weblerson/v2v/pcb/fab/render-revA.png

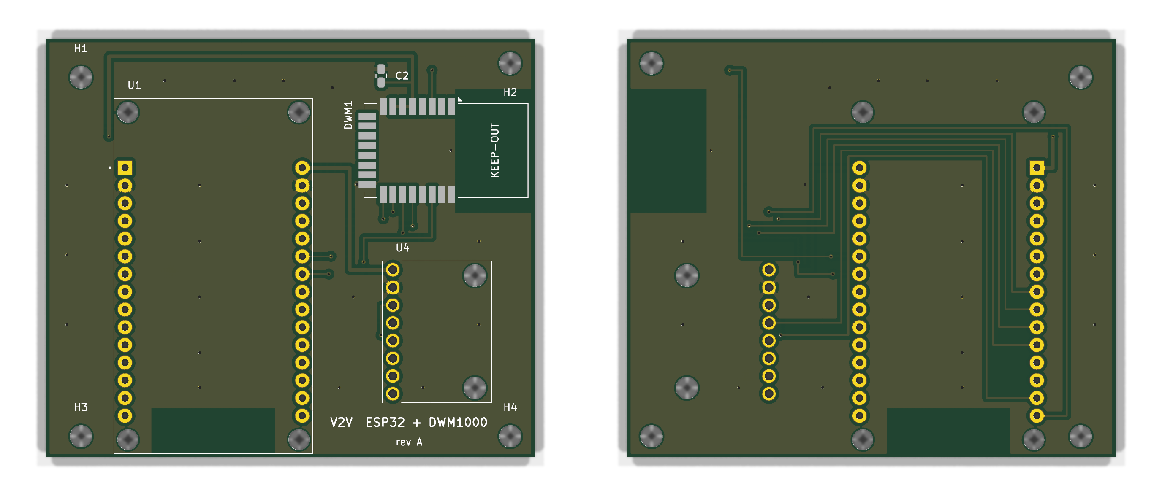
pcb/fab/render-revA.png
