weblerson/v2v/pcb/pcb.kicad_pcb

## KiCad design pcb/pcb.kicad_pcb (2026-09-01)

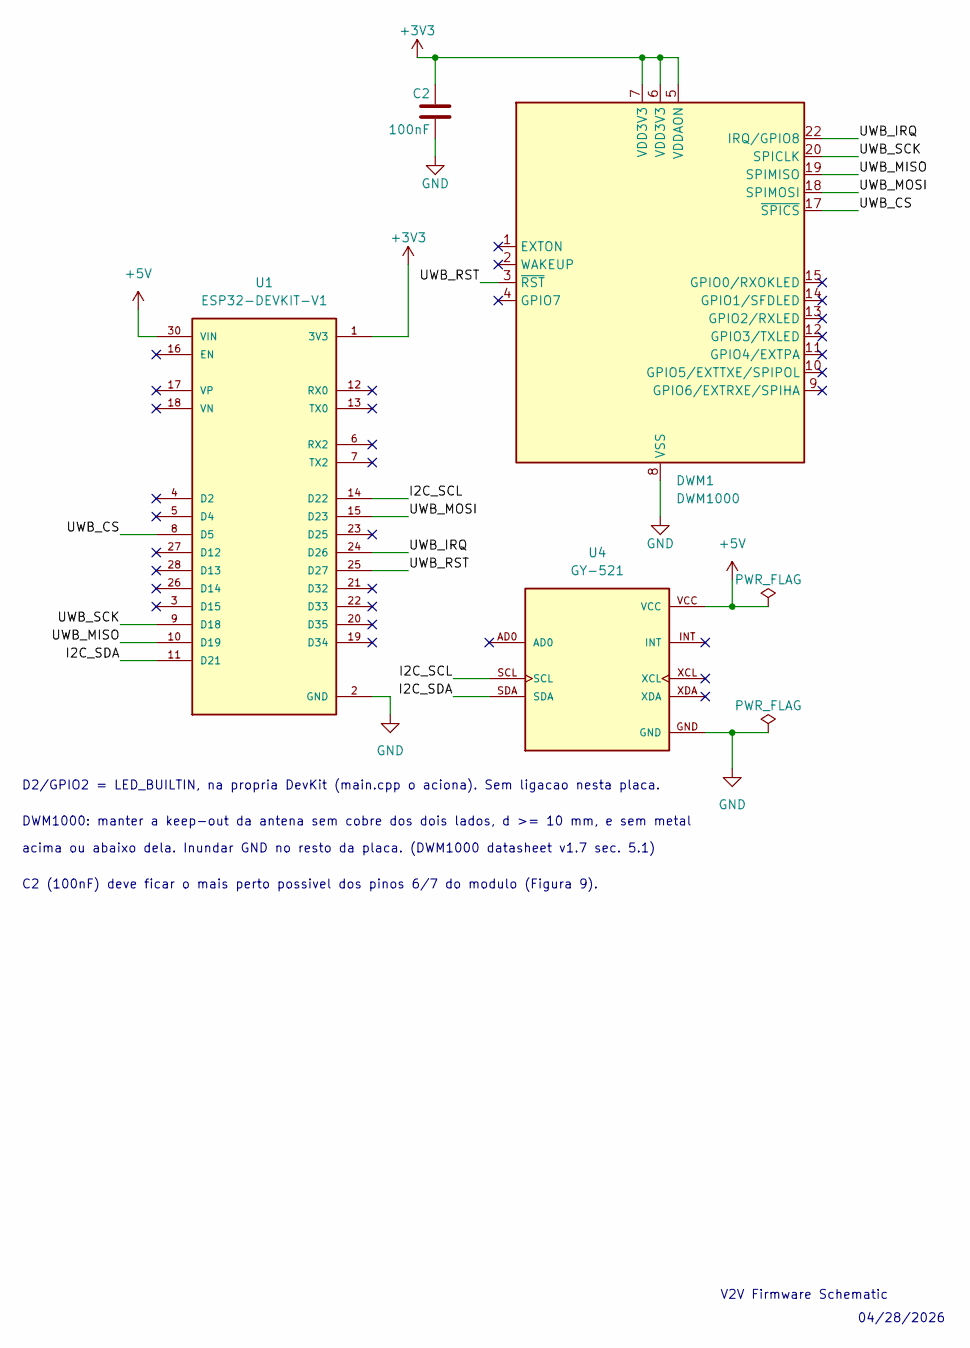
[picture p2: schematic pcb.kicad_sch]

Parts:
C2: 100nF; C_0805_2012Metric
DWM1: DWM1000
U1: ESP32-DEVKIT-V1; MODULE_ESP32_DEVKIT_V1; PARTREV N/A
U4: GY-521; MODULE_GY-521; PARTREV NA

Connections:
+3V3: C2.1, DWM1.5 (VDDAON), DWM1.6 (VDD3V3), DWM1.7 (VDD3V3), U1.1 (3V3)
+5V: U1.30 (VIN), U4.VCC
/I2C_SCL: U1.14 (D22), U4.SCL
/I2C_SDA: U1.11 (D21), U4.SDA
/UWB_CS: DWM1.17 (~SPICS), U1.8 (D5)
/UWB_IRQ: DWM1.22 (IRQ/GPIO8), U1.24 (D26)
/UWB_MISO: DWM1.19 (SPIMISO), U1.10 (D19)
/UWB_MOSI: DWM1.18 (SPIMOSI), U1.15 (D23)
/UWB_RST: DWM1.3 (~RST), U1.25 (D27)
/UWB_SCK: DWM1.20 (SPICLK), U1.9 (D18)
GND: C2.2, DWM1.8 (VSS), DWM1.16 (VSS), DWM1.21 (VSS), DWM1.23 (VSS), DWM1.24 (VSS), U1.2 (GND), U1.29 (GND), U4.GND

Notes on the sheet:
V2V Firmware Schematic
04/28/2026
D2/GPIO2 = LED_BUILTIN, na propria DevKit (main.cpp o aciona). Sem ligacao nesta placa.
DWM1000: manter a keep-out da antena sem cobre dos dois lados, d >= 10 mm, e sem metal
acima ou abaixo dela. Inundar GND no resto da placa. (DWM1000 datasheet v1.7 sec. 5.1)
C2 (100nF) deve ficar o mais perto possivel dos pinos 6/7 do modulo (Figura 9).

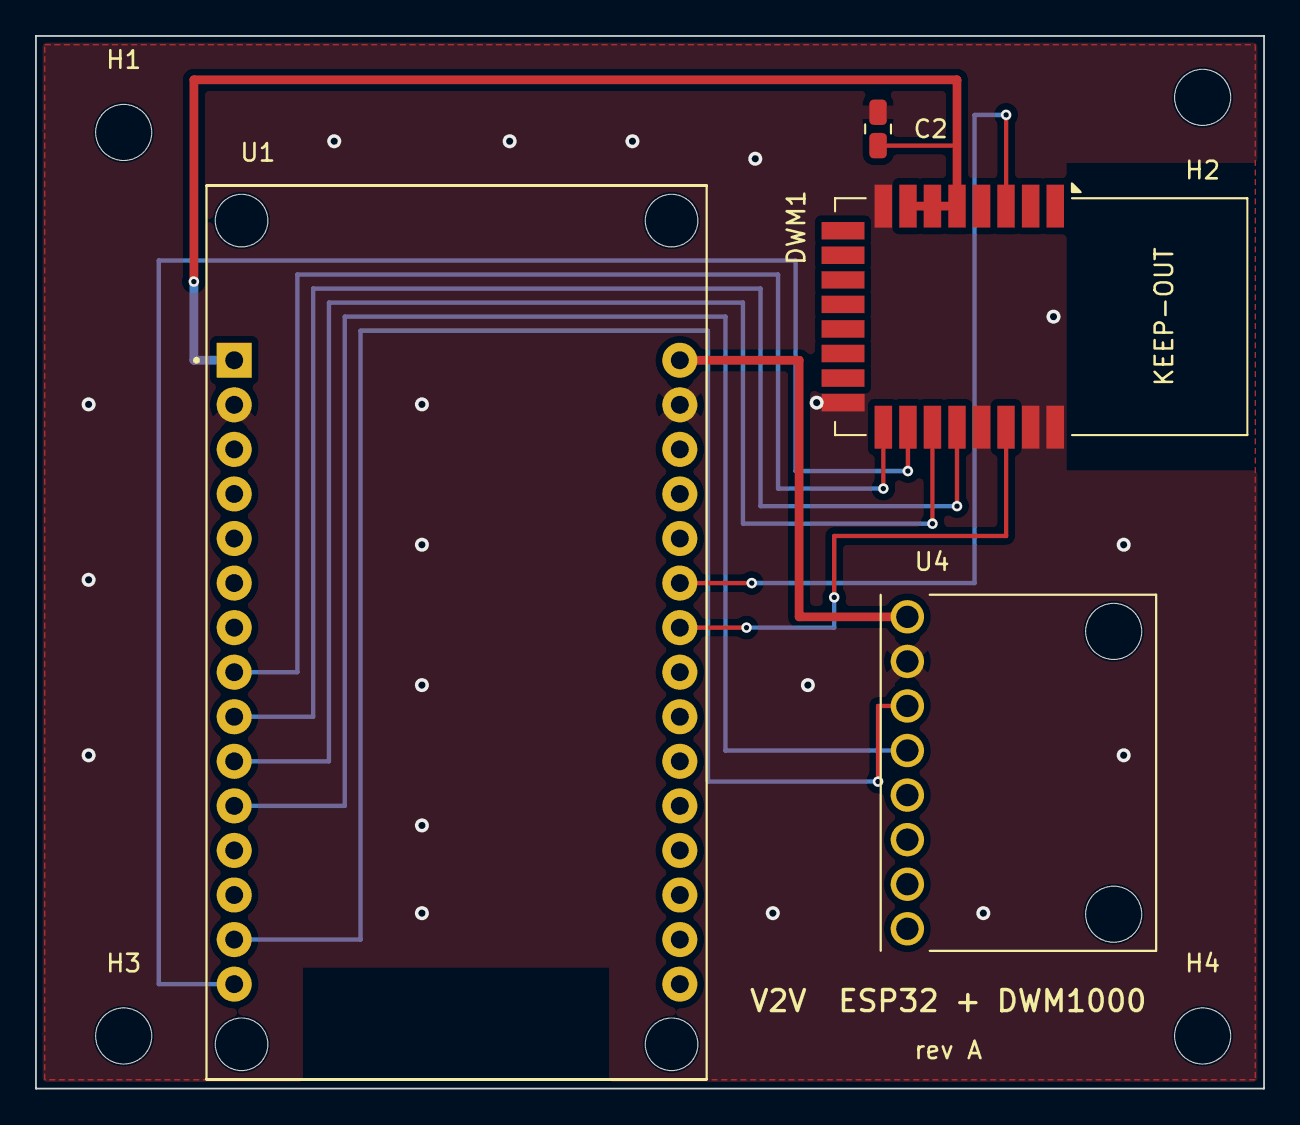
[picture p3: board pcb.kicad_pcb from above]

Board: 2 copper layers, 70.0 x 60.0 mm, 8 parts (0 on the bottom side), 11 nets.

Other parts of the board:
H1, H2, H3, H4: MountingHole_3.2mm_M3
