weblerson/v2v/(commit log)

2026-04-08 movendo para PlatformIO
2026-04-12 primeiro algoritmo de posição e declaração do monolito
2026-09-01 suporte a DWM1000 e PCB
    [pcb-B_Cu.gbr, pcb-B_Mask.gbr, pcb-B_Paste.gbr, pcb-B_Silkscreen.gbr, pcb-Edge_Cuts.gbr, pcb-F_Cu.gbr, pcb-F_Mask.gbr, pcb-F_Paste.gbr]
